sai-ydev/low_cost_pH_meter/pH_meter_top_bom.xlsx

Comment | Designator | Footprint | LCSC Part #
Blue | D1 | 603 | C375575
Qwiic | J2 | JST-1.27mm | C160404
12MHz | Q1 | SMD3225-4P | C654952
Do not Place | R4 | 0603 | Do not Place
0.1uF | C1 C2 C5 C6 C7 C8 C9 C10 C11 C12 C13 C16 C17 C18 C19 C22 C23 C24 C27 C29 C31 C32 C33 C34 | 0603 | C1853272
1.0uF | C3 C4 | 0603 | C26413
1k | R5 R14 R15 R16 | 0603 | C118155
2.2k | R6 R7 R12 R13 | 0603 | C114662
5.1k | R3 R8 | 0603 | C394543
10k | R11 | 0603 | C374544
10uF | C14 C15 C25 C26 C28 C30 | 0603 | C2835565
16.2k | R9 | 0603 | C269411
27 | R1 R2 | 0603 | C3017771
33pF | C20 C21 | 0603 | C440186
100 | R10 R17 R18 | 0603 | C5250752
60312202114511 | J4 J5 | Do not Place | Do not Place
ADM3260ARSZ | U4 | SSOP20 | C658204
BME280 | U2 | PSON65P250X250X100-8N | C92489
LQW18AN2N2C80D | L1 | LQW18AN2N2C80D | C71648
MIC5504-3.3YM5_TR | U3 | SOT95P280X145-5N | C3021093
MOMENTARY-SWITCH-SPST-SMD-4.6X2.8MM | S1 S2 | TACTILE_SWITCH_SMD_4.6X2.8MM | C72443
PH-OEM | U$1 U$2 | PH_SENSOR | Do not Place
RP2040 | U1 | QFN40P700X700X90-57N | C2040
EL0631(TA) | U5 | SOP-8 | C465944
TF-123-ARP9HXX | J3 | MICROSDCARD | C2982548
TYPE-C-31-M-12 | J1 | HRO_TYPE-C-31-M-12 | C165948
W25Q64JVXGIQ | IC1 | SON80P400X400X50-9N | C2940195
WS2812B-2020 | LED1 | WS2812B-2020 | C965555
