sai-ydev/low_cost_pH_meter/pH_meter.brd

## EAGLE design pH_meter.brd (2024-06-02)

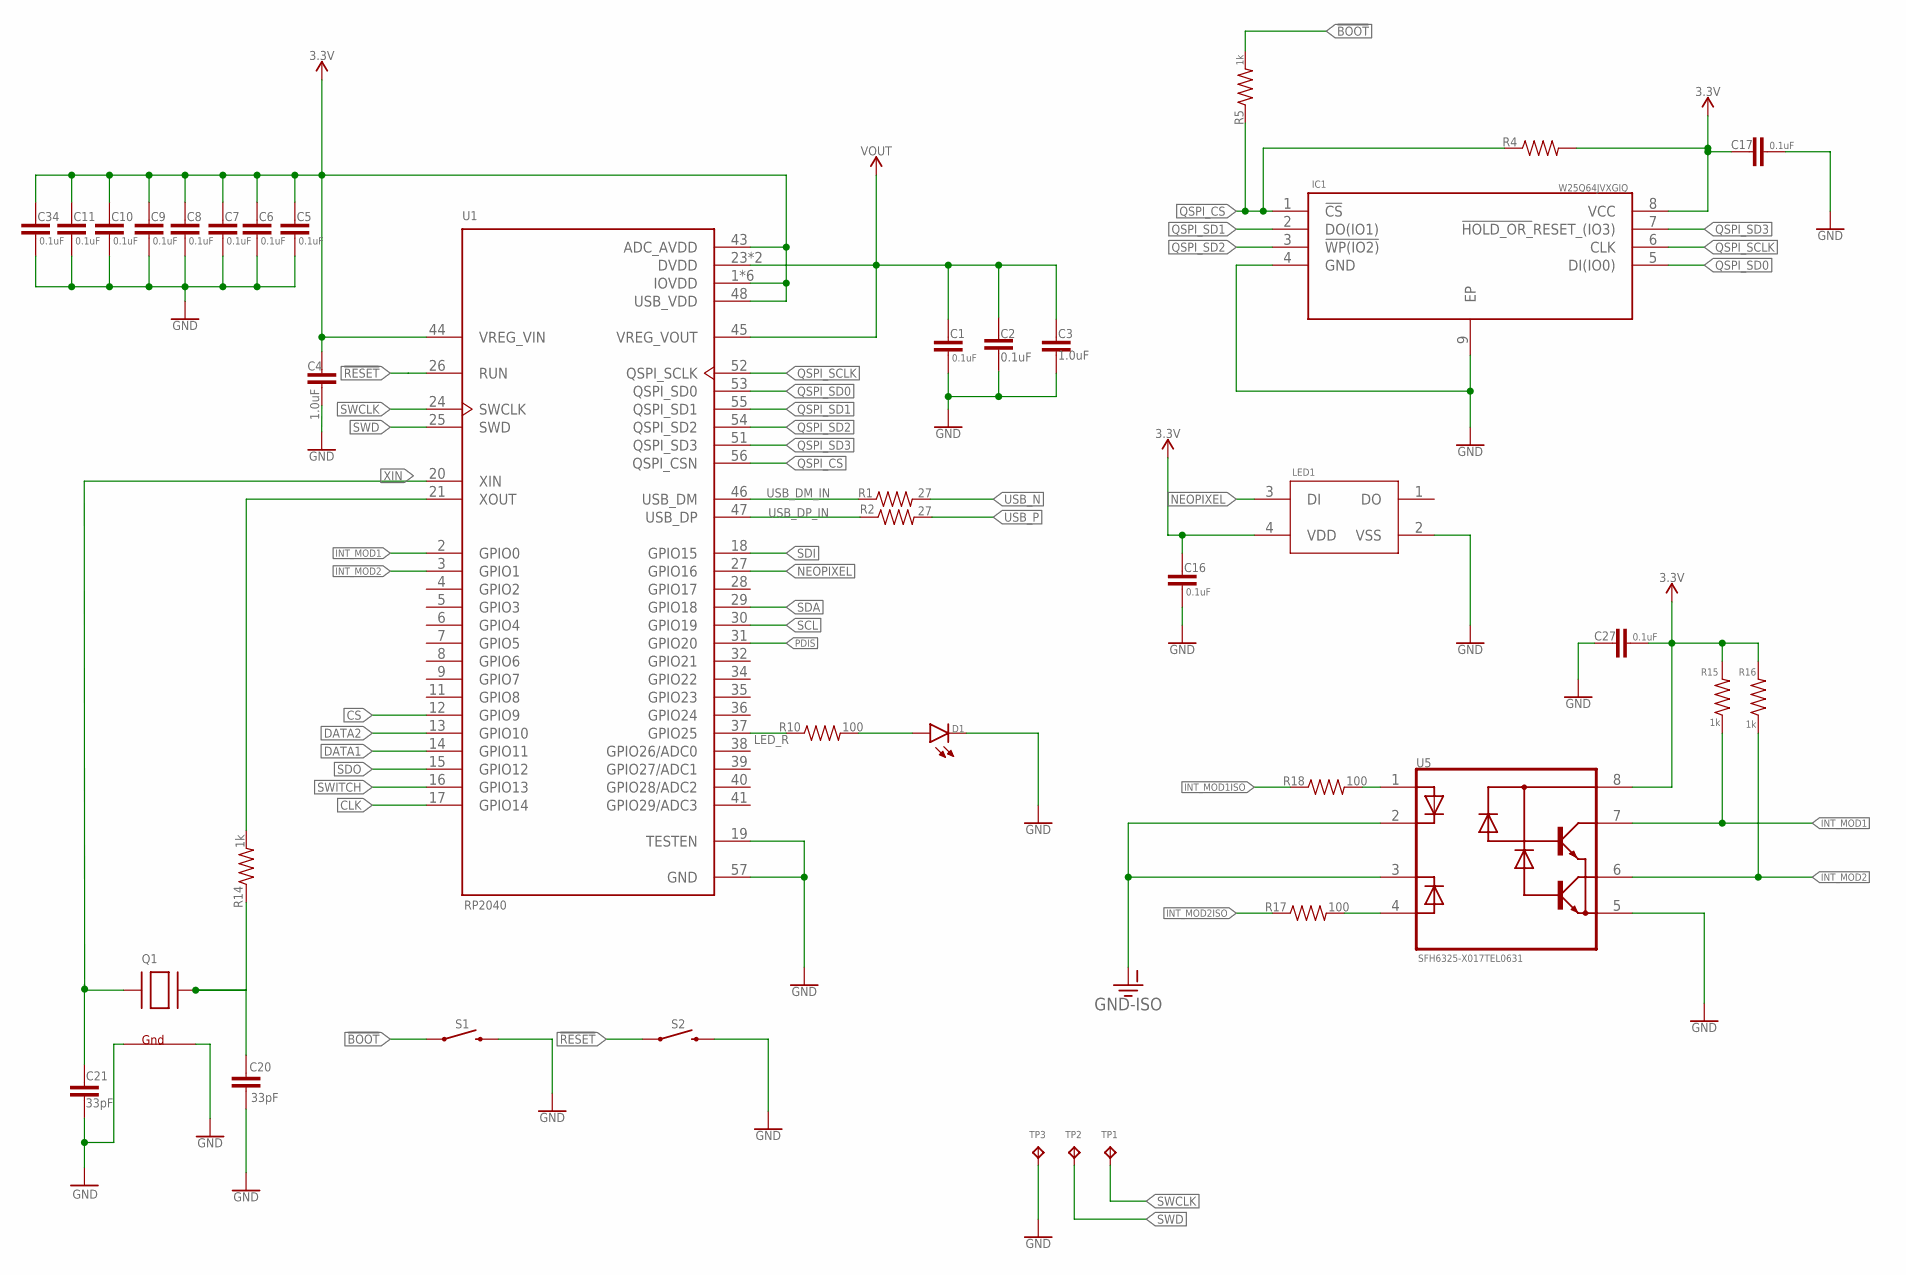
[picture p1: schematic pH_meter.sch, sheet 1]

Parts:
C1, C2, C5, C6, C7, C8, C9, C10, C11, C16, C17, C27, C34: 0.1uF; 0603
C3, C4: 1.0uF; 0603
C20, C21: 33pF; 0603
D1: LED0603; LED-0603
IC1: W25Q64JVXGIQ; SON80P400X400X50-9N
LED1: WS2812B-2020
Q1: XTAL-4-3225; NX3225
R1, R2: 27; 0603
R4: 0603
R5, R14, R15, R16: 1k; 0603
R10, R17, R18: 100; 0603
S1, S2: MOMENTARY-SWITCH-SPST-SMD-4.6X2.8MM; TACTILE_SWITCH_SMD_4.6X2.8MM
TP1, TP2, TP3: TPB2,54; B2,54
U1: RP2040; QFN40P700X700X90-57N
U5: SFH6325-X017TEL0631; SOIC127P599X175-8N

Connections:
3.3V: C4.1, C5.1, C6.1, C7.1, C8.1, C9.1, C10.1, C11.1, C16.1, C17.1, C27.2, C34.1, IC1.8 (VCC), LED1.4 (VDD), R4.2, R15.2, R16.2, U1.1 (IOVDD), U1.10 (IOVDD), U1.22 (IOVDD), U1.33 (IOVDD), U1.42 (IOVDD), U1.43 (ADC_AVDD), U1.44 (VREG_VIN), U1.48 (USB_VDD), U1.49 (IOVDD), U5.8 (C(VCC)); also elsewhere on the board
!BOOT: R5.2, S1.1, S1.2 (1)
!RESET: S2.1, S2.2 (1), U1.26 (RUN)
CLK: U1.17 (GPIO14); also elsewhere on the board
CS: U1.12 (GPIO9); also elsewhere on the board
DATA1: U1.14 (GPIO11); also elsewhere on the board
DATA2: U1.13 (GPIO10); also elsewhere on the board
GND: C1.2, C2.2, C3.2, C4.2, C5.2, C6.2, C7.2, C8.2, C9.2, C10.2, C11.2, C16.2, C17.2, C20.1, C21.1, C27.1, C34.2, D1.C, IC1.4 (GND), IC1.9 (EP), LED1.2 (VSS), Q1.2 (G2), Q1.4 (G1), S1.3 (2), S1.4 (2), S2.3 (2), S2.4 (2), TP3.TP, U1.19 (TESTEN), U1.57 (GND), U5.5 (E(GND)); also elsewhere on the board
GND-ISO: U5.2 (C1), U5.3 (C2); also elsewhere on the board
INT_MOD1: R15.1, U1.2 (GPIO0), U5.7 (C1(VO1))
INT_MOD1ISO: R18.1; also elsewhere on the board
INT_MOD2: R16.1, U1.3 (GPIO1), U5.6 (C2(VO2))
INT_MOD2ISO: R17.1; also elsewhere on the board
LED_R: R10.1, U1.37 (GPIO25)
unnamed: D1.A, R10.2
unnamed: C20.2, Q1.3 (X2), R14.1
unnamed: R14.2, U1.21 (XOUT)
unnamed: R17.2, U5.4 (A2)
unnamed: R18.2, U5.1 (A1)
NEOPIXEL: LED1.3 (DI), U1.27 (GPIO16)
PDIS: U1.31 (GPIO20); also elsewhere on the board
QSPI_CS: IC1.1 (!CS), R4.1, R5.1, U1.56 (QSPI_CSN)
QSPI_SCLK: IC1.6 (CLK), U1.52 (QSPI_SCLK)
QSPI_SD0: IC1.5 (DI(IO0)), U1.53 (QSPI_SD0)
QSPI_SD1: IC1.2 (DO(IO1)), U1.55 (QSPI_SD1)
QSPI_SD2: IC1.3 (!WP(IO2)), U1.54 (QSPI_SD2)
QSPI_SD3: IC1.7 (!HOLD_OR_!RESET_(IO3)), U1.51 (QSPI_SD3)
SCL: U1.30 (GPIO19); also elsewhere on the board
SDA: U1.29 (GPIO18); also elsewhere on the board
SDI: U1.18 (GPIO15); also elsewhere on the board
SDO: U1.15 (GPIO12); also elsewhere on the board
SWCLK: TP1.TP, U1.24 (SWCLK)
SWD: TP2.TP, U1.25 (SWD)
SWITCH: U1.16 (GPIO13); also elsewhere on the board
USB_DM_IN: R1.1, U1.46 (USB_DM)
USB_DP_IN: R2.1, U1.47 (USB_DP)
USB_N: R1.2; also elsewhere on the board
USB_P: R2.2; also elsewhere on the board
VOUT: C1.1, C2.1, C3.1, U1.23 (DVDD), U1.45 (VREG_VOUT), U1.50 (DVDD)
XIN: C21.2, Q1.1 (X1), U1.20 (XIN)

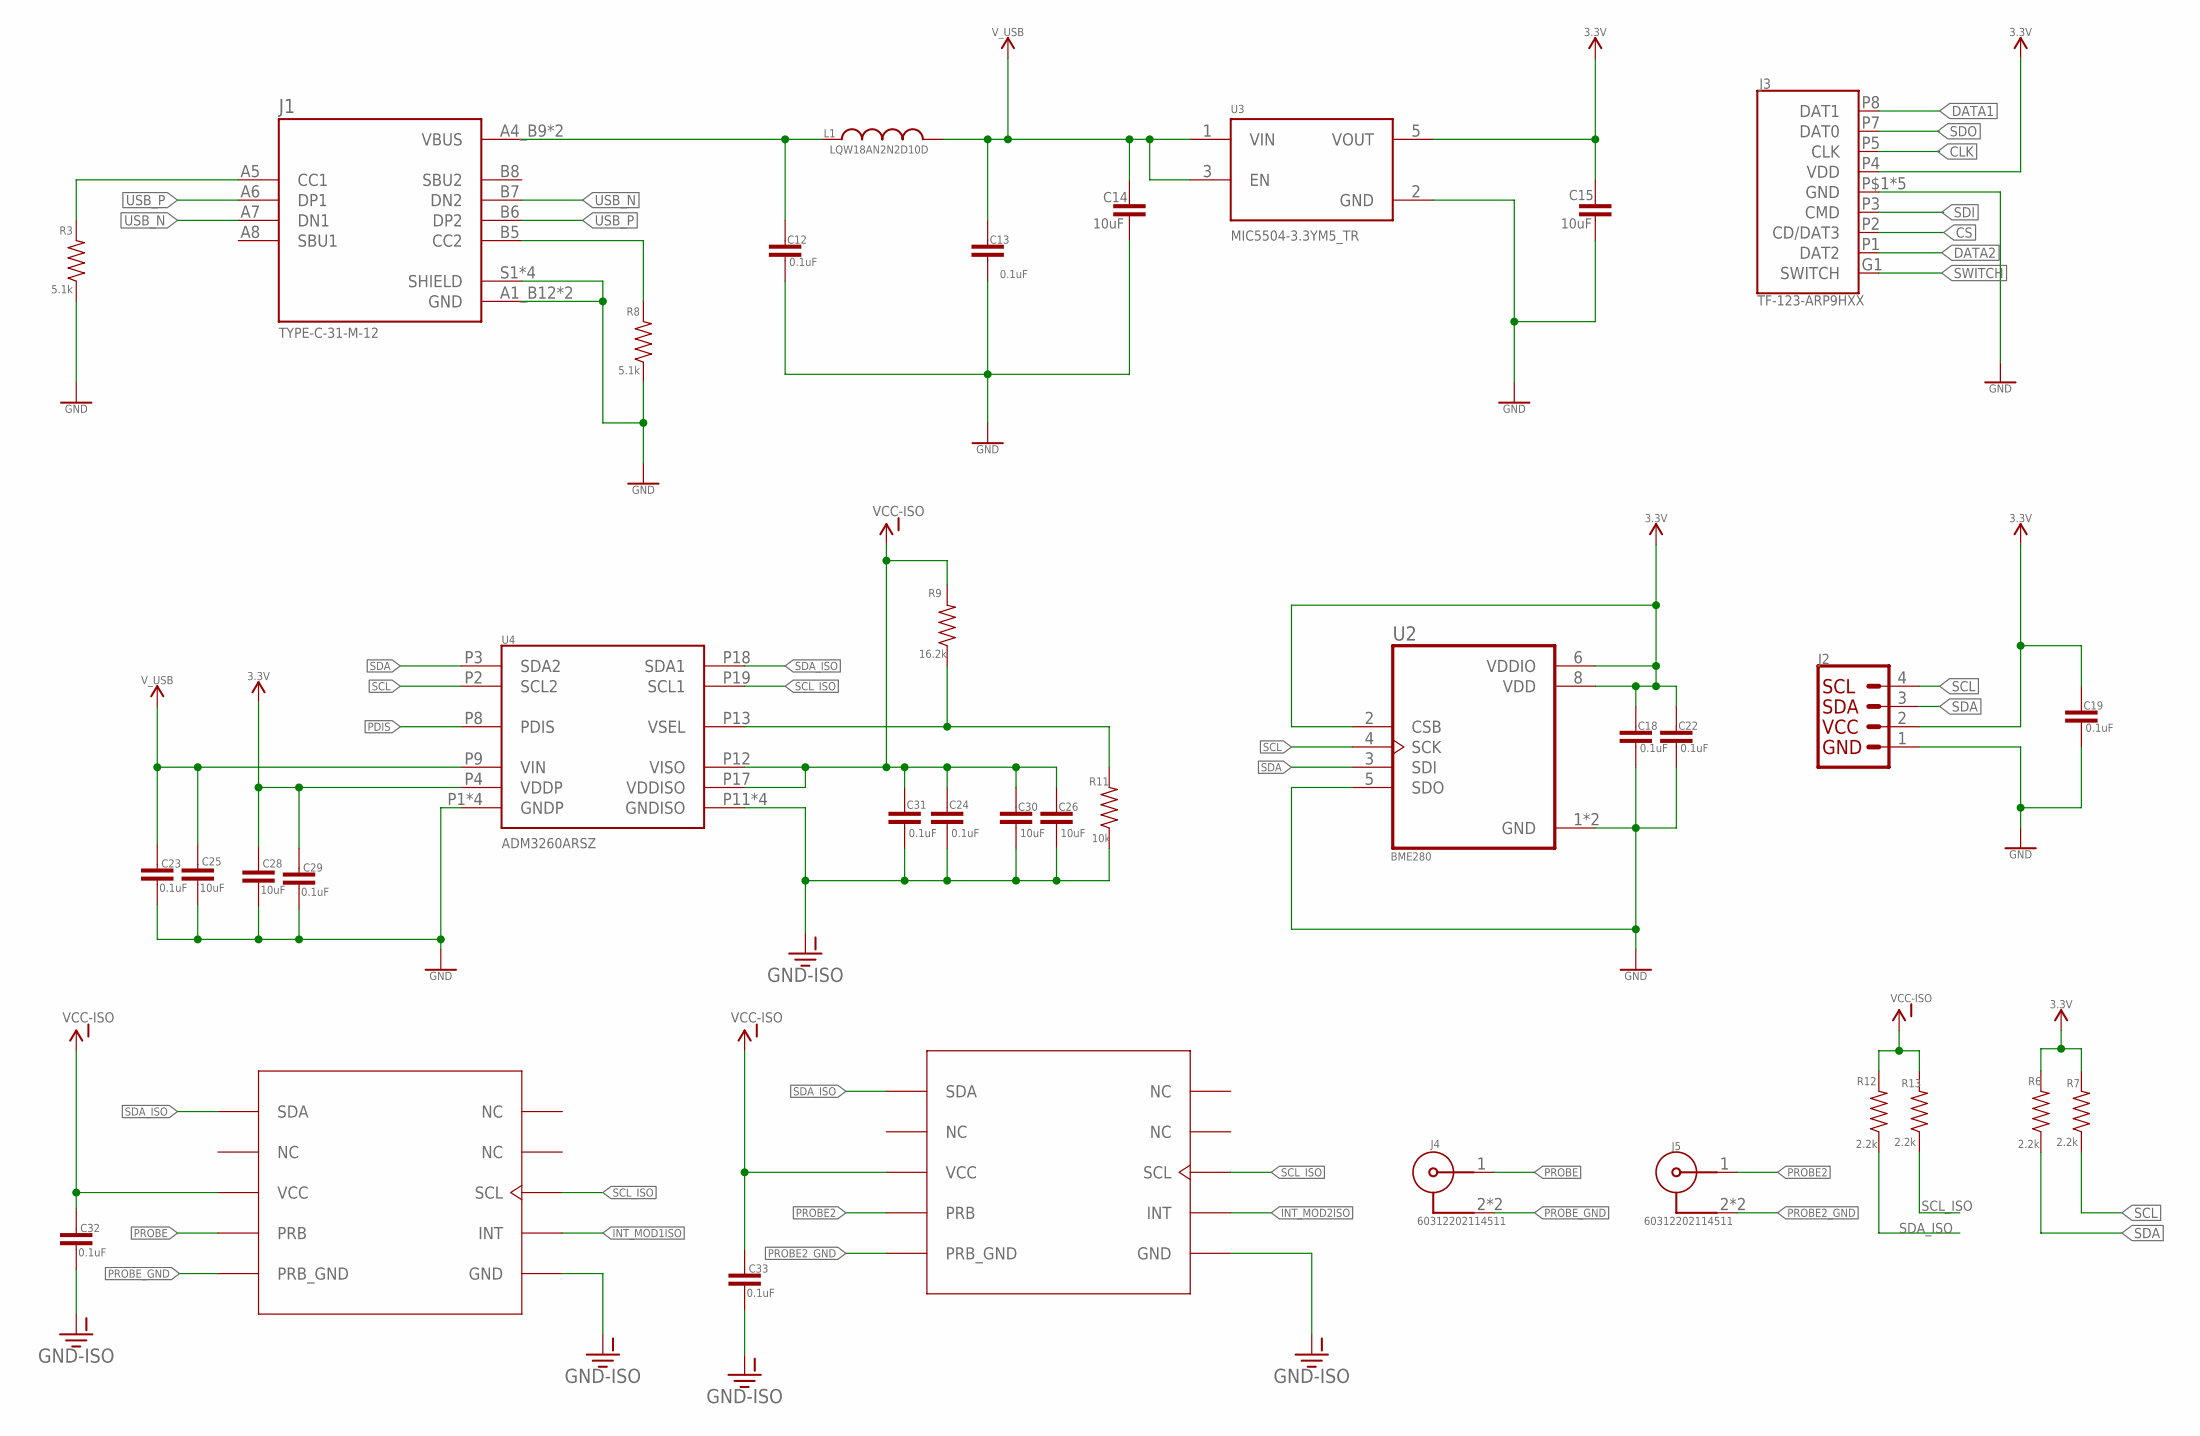
[picture p2: schematic pH_meter.sch, sheet 2]

Parts:
C12, C13, C18, C19, C22, C23, C24, C29, C31, C32, C33: 0.1uF; 0603
C14, C15, C25, C26, C28, C30: 10uF; 0603
J1: TYPE-C-31-M-12; HRO_TYPE-C-31-M-12
J2: QWIIC_CONNECTORJS-1MM; 1X04_1MM_RA
J3: TF-123-ARP9HXX; MICROSDCARD
J4, J5: 60312202114511
L1: LQW18AN2N2D10D; INDC1608X100N
R3, R8: 5.1k; 0603
R6, R7, R12, R13: 2.2k; 0603
R9: 16.2k; 0603
R11: 10k; 0603
U2: BME280; PSON65P250X250X100-8N
U3: MIC5504-3.3YM5_TR; SOT95P280X145-5N
U4: ADM3260ARSZ; SSOP20
U$1, U$2: PH-OEM; PH_SENSOR

Connections:
3.3V: C15.2, C18.1, C19.1, C22.1, C28.1, C29.1, J2.2, J3.P4 (VDD), R6.2, R7.2, U2.2 (CSB), U2.6 (VDDIO), U2.8 (VDD), U3.5 (VOUT), U4.P4 (VDDP); also elsewhere on the board
CLK: J3.P5 (CLK); also elsewhere on the board
CS: J3.P2 (CD/DAT3); also elsewhere on the board
DATA1: J3.P8 (DAT1); also elsewhere on the board
DATA2: J3.P1 (DAT2); also elsewhere on the board
GND: C12.2, C13.2, C14.1, C15.1, C18.2, C19.2, C22.2, C23.2, C25.2, C28.2, C29.2, J1.A1_B12 (GND), J1.B1_A12 (GND), J1.S1 (SHIELD), J1.S2 (SHIELD), J1.S3 (SHIELD), J1.S4 (SHIELD), J2.1, J3.P6 (GND), J3.P$1 (GND), J3.P$2 (GND), J3.P$3 (GND), J3.P$4 (GND), R3.1, R8.1, U2.1 (GND), U2.5 (SDO), U2.7 (GND), U3.2 (GND), U4.P1 (GNDP), U4.P5 (GNDP), U4.P7 (GNDP), U4.P10 (GNDP); also elsewhere on the board
GND-ISO: C24.2, C26.2, C30.2, C31.2, C32.2, C33.2, R11.1, U4.P11 (GNDISO), U4.P14 (GNDISO), U4.P16 (GNDISO), U4.P20 (GNDISO), U$1.P$6 (GND), U$2.P$6 (GND); also elsewhere on the board
INT_MOD1ISO: U$2.P$7 (INT); also elsewhere on the board
INT_MOD2ISO: U$1.P$7 (INT); also elsewhere on the board
unnamed: R9.1, R11.2, U4.P13 (VSEL)
unnamed: J1.A5 (CC1), R3.2
unnamed: J1.B5 (CC2), R8.2
unnamed: C12.1, J1.A4_B9 (VBUS), J1.B4_A9 (VBUS), L1.1
PDIS: U4.P8 (PDIS); also elsewhere on the board
PROBE: J4.1, U$2.P$4 (PRB)
PROBE2: J5.1, U$1.P$4 (PRB)
PROBE2_GND: J5.2, J5.3 (2), U$1.P$5 (PRB_GND)
PROBE_GND: J4.2, J4.3 (2), U$2.P$5 (PRB_GND)
SCL: J2.4, R7.1, U2.4 (SCK), U4.P2 (SCL2); also elsewhere on the board
SCL_ISO: R13.1, U4.P19 (SCL1), U$1.P$8 (SCL), U$2.P$8 (SCL)
SDA: J2.3, R6.1, U2.3 (SDI), U4.P3 (SDA2); also elsewhere on the board
SDA_ISO: R12.1, U4.P18 (SDA1), U$1.P$1 (SDA), U$2.P$1 (SDA)
SDI: J3.P3 (CMD); also elsewhere on the board
SDO: J3.P7 (DAT0); also elsewhere on the board
SWITCH: J3.G1 (SWITCH); also elsewhere on the board
USB_N: J1.A7 (DN1), J1.B7 (DN2); also elsewhere on the board
USB_P: J1.A6 (DP1), J1.B6 (DP2); also elsewhere on the board
VCC-ISO: C24.1, C26.1, C30.1, C31.1, C32.1, C33.1, R9.2, R12.2, R13.2, U4.P12 (VISO), U4.P17 (VDDISO), U$1.P$3 (VCC), U$2.P$3 (VCC)
V_USB: C13.1, C14.2, C23.1, C25.1, L1.2, U3.1 (VIN), U3.3 (EN), U4.P9 (VIN)

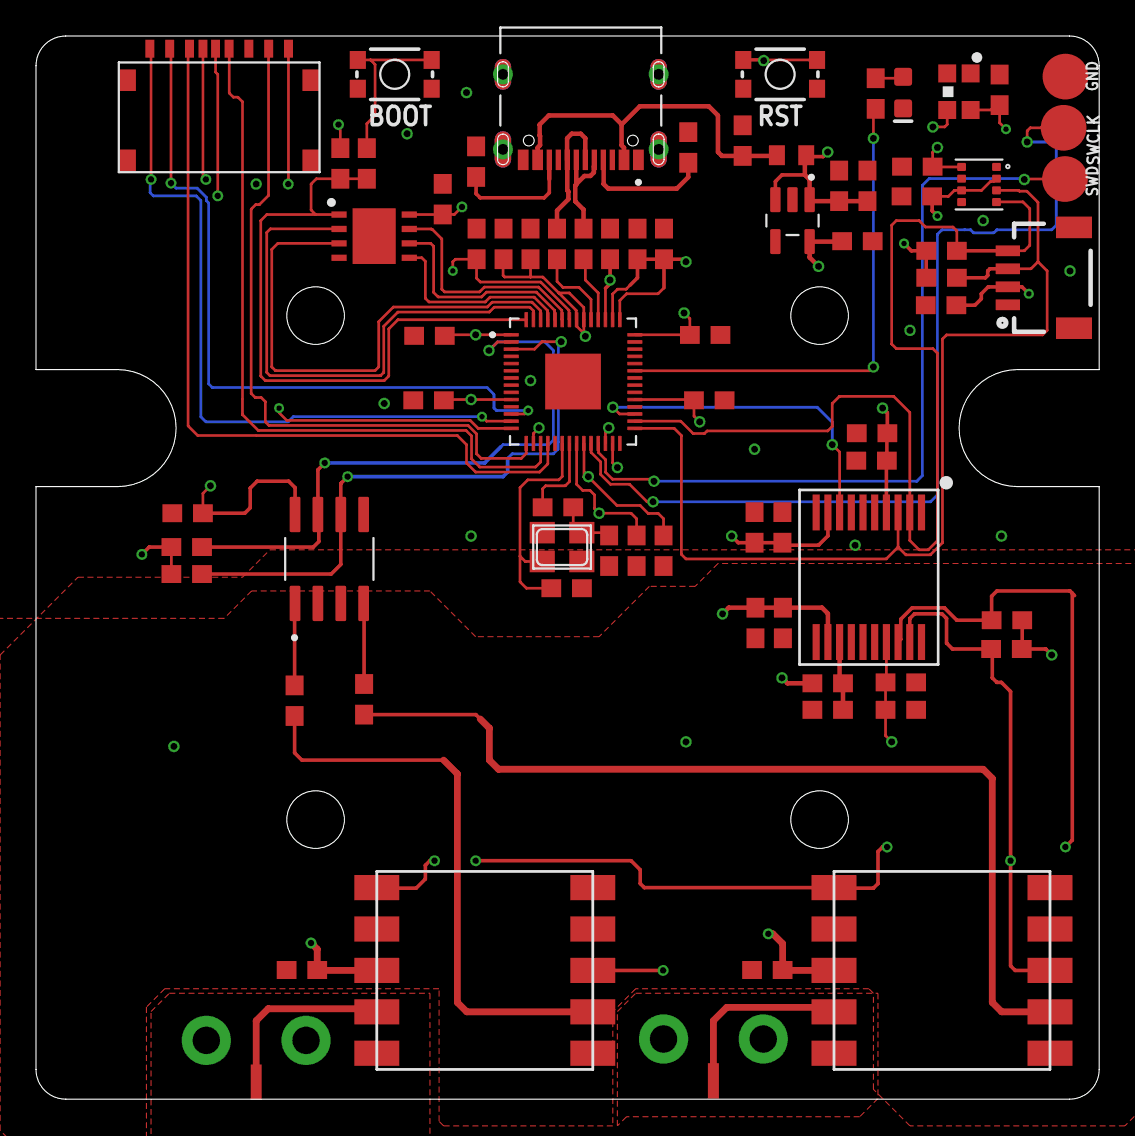
[picture p3: board pH_meter.brd from above]

Board: 4 copper layers, 59.1 x 59.1 mm, 74 parts (0 on the bottom side), 52 nets.
