sai-ydev/low_cost_pH_meter/(commit log)

2024-05-08 Design files check-in
    [pH_meter.brd, pH_meter.sch]
2024-05-19 Daily check-in
    [pH_meter.brd, pH_meter.sch]
2024-05-25 Partial component placement
    [pH_meter.brd, pH_meter.sch]
2024-05-29 Generated gerbers
    [pH_meter.brd, pH_meter.sch, pH_meter_top_bom.csv, pH_meter_top_bom.xlsx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]
2024-05-31 Changes to accommodate BoM costs
    [pH_meter.brd, pH_meter.sch, pH_meter_top_bom.csv, pH_meter_top_bom.xlsx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]
2024-06-02 Updated gerber file checkin
    Removed old gerber files
    [pH_meter.brd, pH_meter.sch, pH_meter_top_bom.csv, pH_meter_top_bom.xlsx]
